guevinn/agv_motorControl_rev0/inv_mtr_ctrl.kicad_pcb

## KiCad design inv_mtr_ctrl.kicad_pcb (2025-11-18)

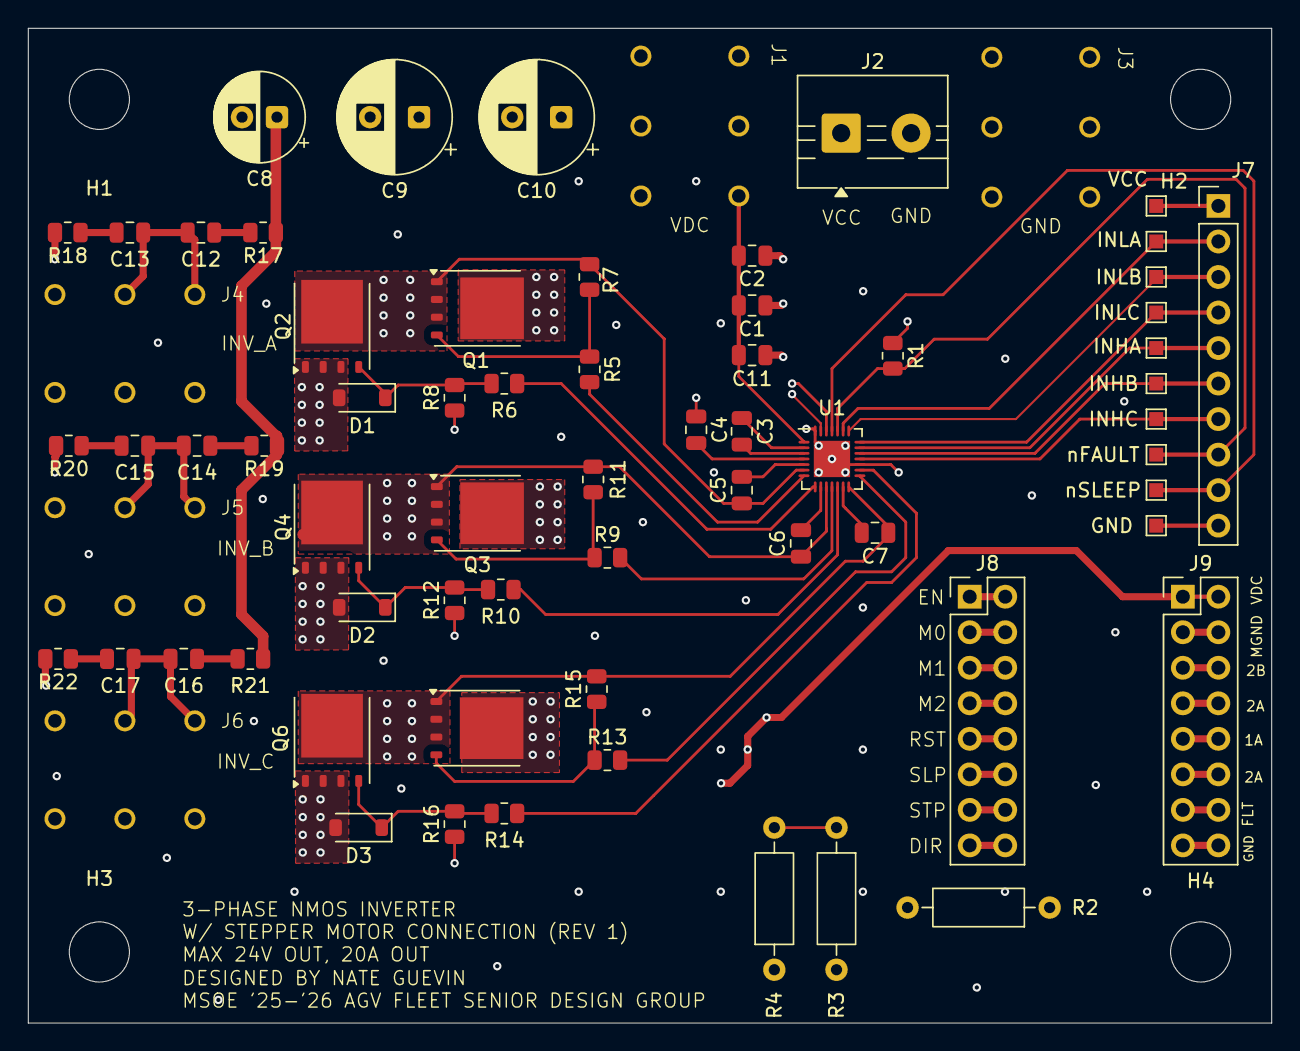
[picture p1: board inv_mtr_ctrl.kicad_pcb from above]

Board: 4 copper layers, 88.9 x 71.1 mm, 72 parts (0 on the bottom side), 54 nets.

Parts:
C1, C4: 10u; C_0805_2012Metric
C2: .1u; C_0805_2012Metric
C3: .47u; C_0805_2012Metric
C5, C6, C7, C11: .01u; C_0805_2012Metric
C8: 100u; CP_Radial_D6.3mm_P2.50mm
C9, C10: 100u; CP_Radial_D8.0mm_P3.50mm
C12, C13, C14, C15, C16, C17: CSNUB; C_0805_2012Metric
D1, D2, D3: D_Zener; D_SOD-123
GND: TestPoint; TestPoint_Pad_1.0x1.0mm
H1, H2, H3, H4: M4; MountingHole_4.3mm_M4
INHA: TestPoint; TestPoint_Pad_1.0x1.0mm
INHB: TestPoint; TestPoint_Pad_1.0x1.0mm
INHC: TestPoint; TestPoint_Pad_1.0x1.0mm
INLB: TestPoint; TestPoint_Pad_1.0x1.0mm
INLC: TestPoint; TestPoint_Pad_1.0x1.0mm
J1, J3, J4, J5, J6: 7799; M4 30A
J2: Screw_Terminal_01x02; TerminalBlock_MaiXu_MX126-5.0-02P_1x02_P5.00mm
J7: Conn_01x10; PinHeader_1x10_P2.54mm_Vertical
J8, J9: Conn_02x08_Odd_Even; PinHeader_2x08_P2.54mm_Vertical
Q1, Q2, Q3, Q4, Q5, Q6: BSC067N06LS3GATMA1; TDSON-8-1
R1, R7, R8, R11, R12, R15, R16: 10k; R_0805_2012Metric
R2: 1k; R_Axial_DIN0207_L6.3mm_D2.5mm_P10.16mm_Horizontal
R3: 141k; R_Axial_DIN0207_L6.3mm_D2.5mm_P10.16mm_Horizontal
R4: 10k; R_Axial_DIN0207_L6.3mm_D2.5mm_P10.16mm_Horizontal
R5, R6, R9, R10, R13, R14: 31; R_0805_2012Metric
R17, R18, R19, R20, R21, R22: RSNUB; R_0805_2012Metric
TP8: TestPoint; TestPoint_Pad_1.0x1.0mm
U1: DRV8328_4mm_x_4mm_WQFN
VCC: TestPoint; TestPoint_Pad_1.0x1.0mm
nFAULT: TestPoint; TestPoint_Pad_1.0x1.0mm
nSLEEP: TestPoint; TestPoint_Pad_1.0x1.0mm

Connections:
/1A: J9.9, J9.10
/1B: J9.7, J9.8
/2A: J9.11, J9.12
/2B: J9.5, J9.6
/A_INV: C5.1, C12.1, C13.2, J4.1, Q1.1 (S), Q1.2 (S), Q1.3 (S), Q2.5 (D), R7.2, U1.6 (SHA)
/B_INV: C6.1, C14.1, C15.2, J5.1, Q3.1 (S), Q3.2 (S), Q3.3 (S), Q4.5 (D), R11.2, U1.10 (SHB)
/C_INV: C7.1, C16.1, C17.2, J6.1, Q5.1 (S), Q5.2 (S), Q5.3 (S), Q6.5 (D), R15.2, U1.14 (SHC)
/DIR: J8.15, J8.16
/EN_DRV25: J8.1, J8.2
/FAULT: J9.13, J9.14
/GHA: R5.2, U1.7 (GHA)
/GHB: R9.2, U1.11 (GHB)
/GHC: R13.2, U1.15 (GHC)
/GLA: R6.2, U1.8 (GLA)
/GLB: R10.2, U1.12 (GLB)
/GLC: R14.2, U1.16 (GLC)
/GVDD: C4.2, U1.4 (GVDD)
/INHA: INHA.1, J7.5, U1.20 (INHA)
/INHB: INHB.1, J7.6, U1.19 (INHB)
/INHC: INHC.1, J7.7, U1.18 (INHC)
/INLA: J7.2, TP8.1, U1.23 (INLA)
/INLB: INLB.1, J7.3, U1.22 (INLB)
/INLC: INLC.1, J7.4, U1.21 (INLC)
/M0: J8.3, J8.4
/M1: J8.5, J8.6
/M2: J8.7, J8.8
/M_GND: J9.3, J9.4
/RST: J8.9, J8.10
/SLP: J8.11, J8.12
/STEP: J8.13, J8.14
/nFAULT: J7.8, R1.2, U1.24 (nFAULT), nFAULT.1
/nSLEEP: J7.9, U1.25 (nSLEEP), nSLEEP.1
GND: C1.1, C2.1, C4.1, C8.2, C9.2, C10.2, C11.1, D1.2 (A), D2.2 (A), D3.2 (A), GND.1, J2.2, J3.1, J7.10, J9.15, J9.16, Q2.1 (S), Q2.2 (S), Q2.3 (S), Q4.1 (S), Q4.2 (S), Q4.3 (S), Q6.1 (S), Q6.2 (S), Q6.3 (S), R2.1, R4.1, R8.1, R12.1, R16.1, R18.2, R20.2, R22.2, U1.17 (LSS), U1.28 (GND), U1.29 (THERM)
unnamed: C12.2, R17.2
unnamed: C13.1, R18.1
unnamed: C14.2, R19.2
unnamed: C15.1, R20.1
unnamed: C16.2, R21.2
unnamed: C17.1, R22.1
unnamed: D1.1 (K), Q2.4 (G), R6.1, R8.2
unnamed: D2.1 (K), Q4.4 (G), R10.1, R12.2
unnamed: D3.1 (K), Q6.4 (G), R14.1, R16.2
unnamed: Q1.4 (G), R5.1, R7.1
unnamed: Q3.4 (G), R9.1, R11.1
unnamed: Q5.4 (G), R13.1, R15.1
unnamed: C5.2, U1.5 (BSTA)
unnamed: C6.2, U1.9 (BSTB)
unnamed: C7.2, U1.13 (BSTC)
unnamed: C3.2, U1.3 (CPH)
unnamed: C3.1, U1.2 (CPL)
unnamed: R2.2, U1.27 (DT)
unnamed: R3.1, R4.2, U1.26 (VDSLVL)
VCC: J2.1, J7.1, R1.1, R3.2, VCC.1
VDC: C1.2, C2.2, C8.1, C9.1, C10.1, C11.2, J1.1, J9.1, J9.2, Q1.5 (D), Q3.5 (D), Q5.5 (D), R17.1, R19.1, R21.1, U1.1 (PVDD)
