guevinn/agv_motorControl_rev0/(commit log)

2025-11-04 Updated stackup
    [inv_mtr_ctrl.kicad_pcb, inv_mtr_ctrl.kicad_sch]
2025-11-04 Component placements
    [inv_mtr_ctrl.kicad_pcb]
2025-11-04 Placed test points and decoupling caps
    [inv_mtr_ctrl.kicad_pcb, inv_mtr_ctrl.kicad_sch]
2025-11-04 routed passives and test points
    [inv_mtr_ctrl.kicad_pcb]
2025-11-04 Routed non-inverter signals and moved header signals around
    [inv_mtr_ctrl.kicad_pcb, inv_mtr_ctrl.kicad_sch]
2025-11-05 Ground pours on layers 2 and 3
    [inv_mtr_ctrl.kicad_pcb]
2025-11-05 Drew pour areas prior to getting advice from Dr. Rothe
    [inv_mtr_ctrl.kicad_pcb]
2025-11-06 Updated pour areas to have larger area for escape traces on FET to phase connections. Trace length of GL traces was compromised to do this
    [inv_mtr_ctrl.kicad_pcb]
2025-11-06 Moved screw terminals
    [inv_mtr_ctrl.kicad_pcb]
2025-11-06 Checkpoint before filling zones
    [inv_mtr_ctrl.kicad_pcb]
2025-11-06 Initial zone fill and connections
    [inv_mtr_ctrl.kicad_pcb]
2025-11-07 Updated fill areas to be solid instead of thermal
    [inv_mtr_ctrl.kicad_pcb]
2025-11-07 Pre-Rothe meeting board
    [inv_mtr_ctrl.kicad_pcb]
2025-11-07 Added additional copper pours and moved through hole resistors
    [inv_mtr_ctrl.kicad_pcb]
2025-11-07 Updated trace routing and boostrap capacitor placement
    [inv_mtr_ctrl.kicad_pcb]
2025-11-10 Starting point for Rothe meeting
    [inv_mtr_ctrl.kicad_pcb]
2025-11-10 Alternative FET and trace layout prior to Rothe meeting
    [inv_mtr_ctrl.kicad_pcb]
2025-11-10 Rothe review done. Implementing alternative inverter layout and then merging with origin
    [inv_mtr_ctrl.kicad_pcb]
2025-11-10 Implemented alternative inverter routing and added splash on silkscreen
    [inv_mtr_ctrl.kicad_pcb]
2025-11-11 Placed ground plane stitching vias. Also switched all vias to through to minimize board cost
    [inv_mtr_ctrl.kicad_pcb]
2025-11-14 Board layout initial BOM w/ layout
    [inv_mtr_ctrl.kicad_pcb, inv_mtr_ctrl.kicad_sch]
2025-11-18 Ordering PCB
    [inv_mtr_ctrl.kicad_pcb, inv_mtr_ctrl.kicad_sch]
